TobyM-engineering/Iron-Man-Gauntlet-Mark-1/hardware/wiring-diagram-dark.png

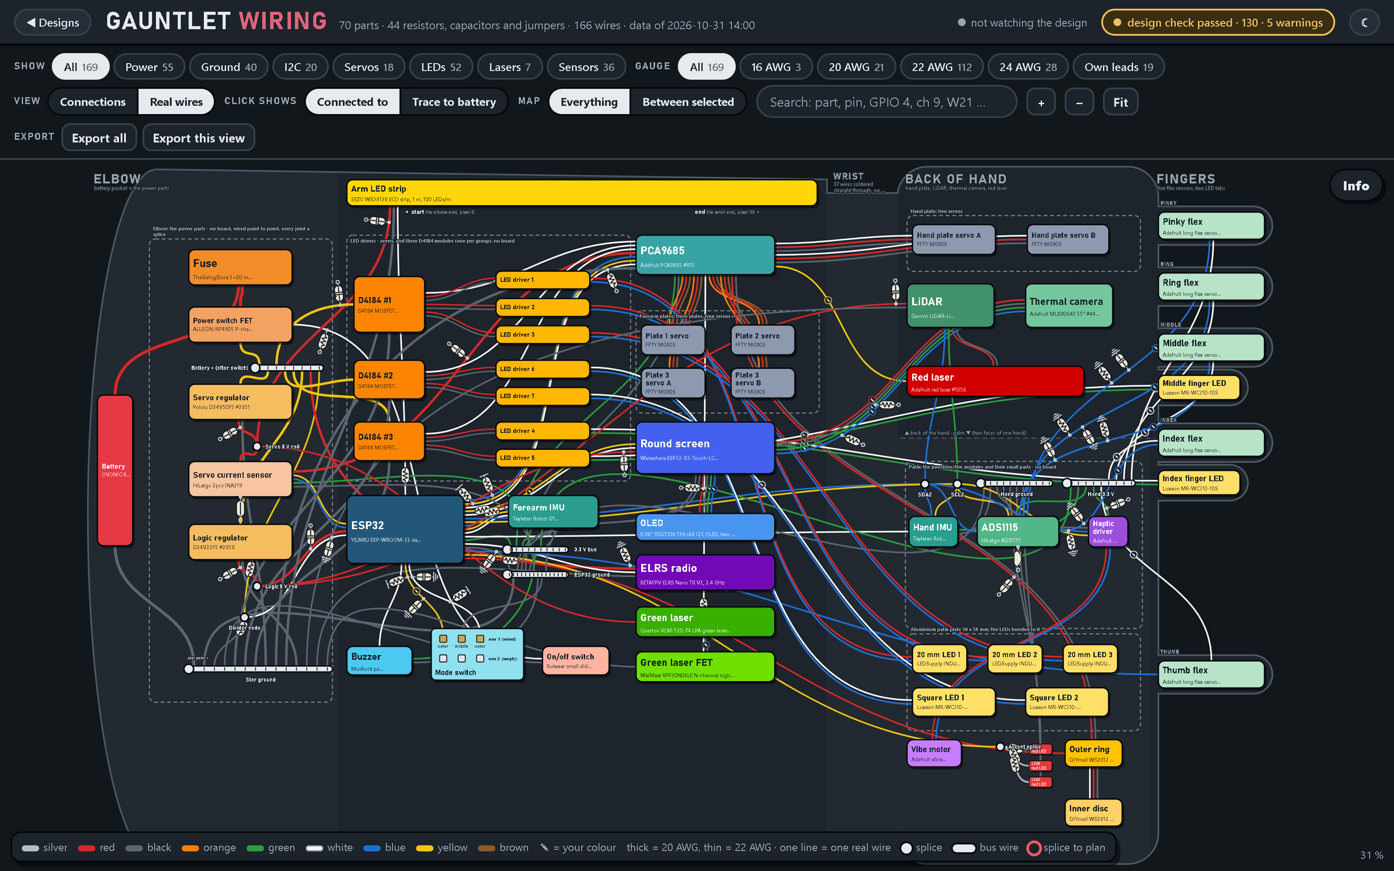
hardware/wiring-diagram-dark.png
