TobyM-engineering/Iron-Man-Gauntlet-Mark-1/firmware/Puck/Puck.ino

// Puck - round-screen display for the R3 gauntlet (Waveshare ESP32-S3-Touch-LCD-1.28).
// The code lives in app.cpp; knobs in config.h; the arm model in model_data.h (kept off the repository) or else
// model_standin.h (simple blocks) - kin.h picks.
// Display only: this board never commands a servo.

void app_setup();
void app_loop();

void setup() { app_setup(); }
void loop() { app_loop(); }
