TobyM-engineering/Iron-Man-Gauntlet-Mark-1/(commit log)

2026-10-31 Iron Man Gauntlet Mark 1: firmware, hardware and photos
    The arm's firmware (Ironman), the round screen's firmware (Puck and its
    WiFi update mode), the arm-to-screen protocol, the browser pages the arm
    serves, the parts list, pin map and power tree, the system overview and
    wiring diagrams, and photos of the finished build.
2026-10-31 README: two photos at the top, wiring right after the background, shorter text
2026-11-01 The wiring app: the full Mark 1 wiring to click through in a browser - every part, pin, wire, resistor and capacitor, each wire's gauge, length and current, and the path back to the battery. Linked f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
2026-11-01 README: the drone is flown by the arm itself; no mention of the earlier test glove
2026-11-01 The servo driver's channels as built: the wiring app and the hardware page name the header each wire is plugged into on the arm (plates 1-3 on 13 / 12 / 14 / 15, the hand plate on 0 / 1, the red lase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
2026-11-07 The screen's arm model: the stand-in is committed as model_standin.h; a full model_data.h beside it stays on this PC (gitignored) and kin.h uses it when present. .githooks refuse the full model in an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
