TobyM-engineering/Iron-Man-Gauntlet-Mark-1/(notices)

Notices in the files:
README.md:
License: MIT
